natesales/openreactor/turbo/README.md

# Pfeiffer Turbomolecular Pump Controller

## Registers

- 2 - standby
- 302 - all zeroes at startup, docs say "rotation speed switchpoint attained"
- 303 - all zeroes at startup, docs say error code
- 306 - all zeroes at startup, docs say "set rotation speed attained"
- 309 - pump speed
- 310 - value changes...might be pump current?
- 312 - "V  2.8" - firmware version?

### Measured Values

- 302 111111
- 303 000000
- 306 000000
- 307 000000
- 308 001500
- 309 000770
- 310 000153
- 312 V  2.8
