natesales/openreactor/cmd/hv/README.md

# High Voltage Supply Controller

HVSC

1 +10Vdc Reference +10Vdc @ 1mA, maximum
2 Current Program 0 to 10Vdc = 0 to 100% rated output, Zin = 10MΩ

3 (1) Voltage Monitor 0 to 10Vdc = 0 to 100% rated output, Zout = 10kΩ
4 (2) Voltage Program 0 to 10Vdc = 0 to 100% rated output, Zin = 10MΩ
5 (3) Common Ground Power Ground
6 (4) Current Monitor 0 to 10Vdc = 0 to 100% rated output, Zout = 10kΩ
7 (5) Enable/Inhibit Ground = Inhibit, Open = HV ON
8 (6) OVP Indicator Collector w/1kΩ pull up to +5Vdc, transistor on = OVP
9 (7) Signal Return Signal Return

- 2x 0-10V inputs
- 2x 0-10V outputs
- 1x mosfet switch or relay for inhibit
