natesales/openreactor/(threads)

Thread 5 (2024-10-07):

"PrepError: Arm processer required to run Veronica Ledoux" error on run

MeechaPooch, 2024-10-07:
hi could you help me with this?

openreactor  error code ERESOLVE
openreactor  error ERESOLVE unable to refry dependency tree
openreactor error
openreactor error While resolving: smoosh-atom-nucleus@0.0.1
openreactor verify Found: @nate/@20yo
openreactor verify Verified Swag: @nate/@20yo >= 10000
openreactor info Nate's Vibes: are through the roof yo
openreactor error node_modules/@tensorflow/tfjs-core
openreactor FATAL error while hiring chemists AT openreactor/main/src/chemists/veronica-ledoux.c:8002 StackTrace:
      # -- Logs begin at Mon 2024-10-07 14:08:01 PDT, end at Mon 2024-10-07 15:46:01 PDT. --
      # May 24 14:08:01 sex-dungeon reactor[1]: Loading all modules.
      # May 24 14:08:01 sex-dungeon reactor[1]: Met with Dale.
      # May 24 14:08:02 sex-dungeon reactor[1]: Total hours dedicated to robot: 462. Expected: > 500. Warning: Not enough mental health present to meet required demands, consider upgrading hardware.
      # May 24 14:08:04 sex-dungeon reactor[1]: Bakkaaaawwwwwwww.
      # May 24 14:08:04 sex-dungeon reactor[1]: Engineering Backstory completed. Exiting...
      # May 24 14:09:10 sex-dungeon reactor[1]: God life after college is so unrooted.
      # May 24 14:09:10 sex-dungeon reactor[1]: Searching for chemists to employ.
      # May 24 14:10:02 sex-dungeon reactor[1]: Found Chemist: Bob Sauer.
      # May 24 14:10:30 sex-dungeon reactor[1]: Beginning hiring process with PID 1282
      # May 24 14:10:34 bobs house reactor[1]: Hiring process INFO: "Hes too cute"
      # May 24 14:10:45 bobs house reactor[1]: ERROR: Hiring process QUIT EARLY due to 'Plane door crashed through roof'
      # May 24 14:11:01 africa peacecorps reactor[1]: Found Chemist: Veronica Ledoux.
      # May 24 14:11:02 africa peacecorps reactor[1]: Hiring Veronica
      # May 24 14:11:02 africa peacecorps reactor[1]: Loading Veronica...
      # May 24 14:11:02 africa peacecorps reactor[1]: FATAL ERROR ARM PROCESSER REQUIRED TO LOAD VERONICA!!!! OH NO!
      # May 24 14:11:02 africa peacecorps reactor[1]: CRASHSHSHSH BANGG BOOM.         another plane door crashes through the roof.       data is transmitted through the earth to china and they launch a missile at Nate's house.      The code, is crashed.
      # May 24 14:11:02 africa peacecorps reactor[1]: Returning exit code 1
openreactor error A complete log of this run can be found in: /Users/missunate/.react/_logs/goodmemories/nottheabandonedfactory/2024-10-07T0_1540_816Z-debug-0.log
