natesales/openreactor/(commit log)

2024-06-09 feat: switch to edwards AIM-L gauge
2024-06-25 feat: FSM steppers
2024-06-26 feat: FSM state steppers
2024-06-27 refactor: use generic flowRate parameter
2024-06-30 feat(hv): current monitoring and internal failsafe
    [default.yml, hv.ino]
2024-07-01 feat(fsm): add gas flow control loop
2024-07-01 fix(ui): stepper spacing
2024-07-03 fix(line): marshal line to string
    [default.yml]
